gobgob/balise/solidworks/cahpeau.SLDPRT

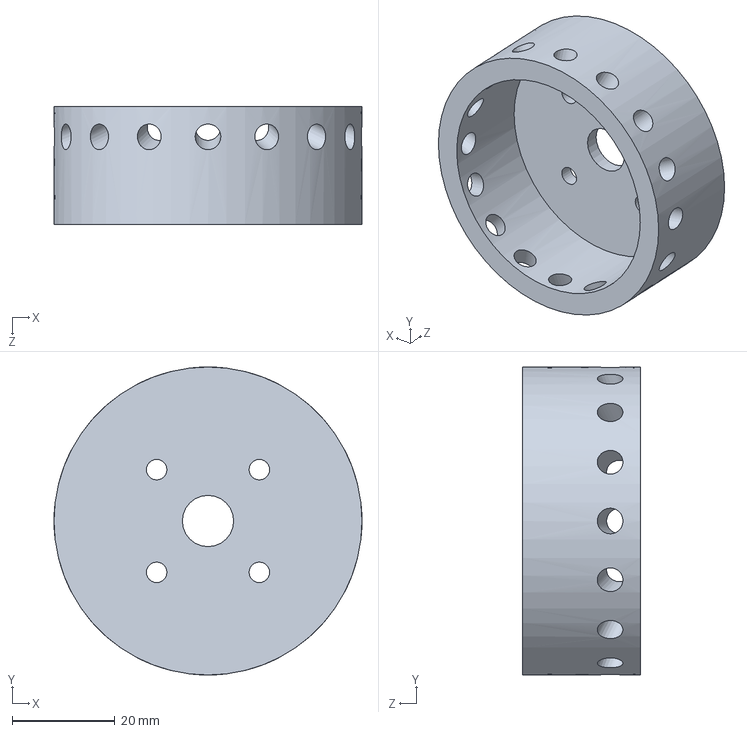
[picture p1: CAD file, 2015-05-18]
solidworks/cahpeau.SLDPRT
60.0 x 60.0 x 23.0 mm
