gobgob/balise/solidworks/haut.SLDPRT

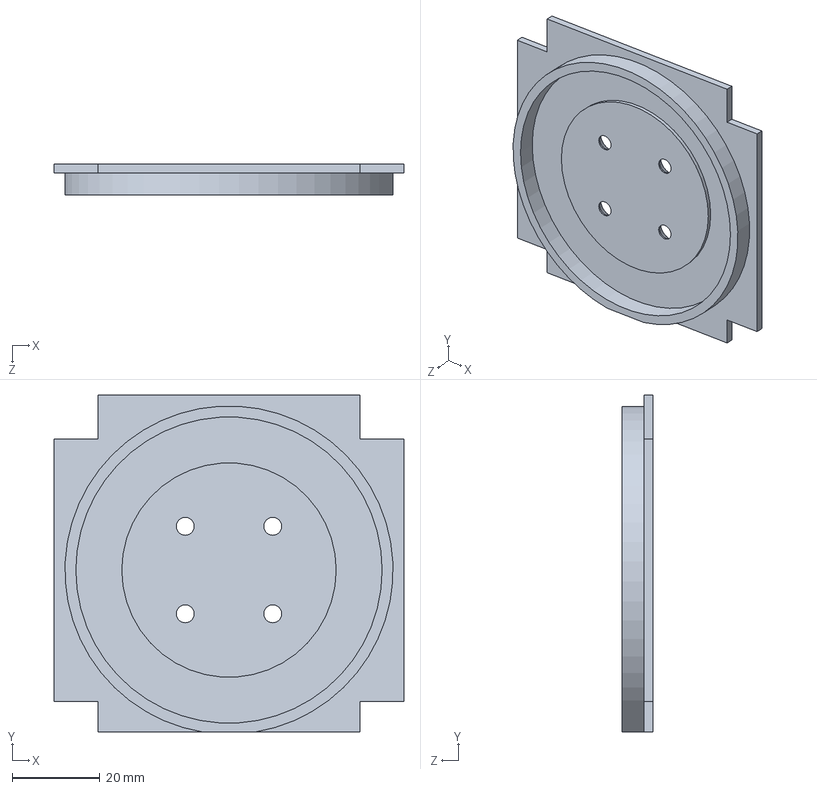
[picture p2: CAD file, 2015-05-18]
solidworks/haut.SLDPRT
80.0 x 77.0 x 7.00 mm
