gobgob/balise/solidworks/inter.SLDPRT

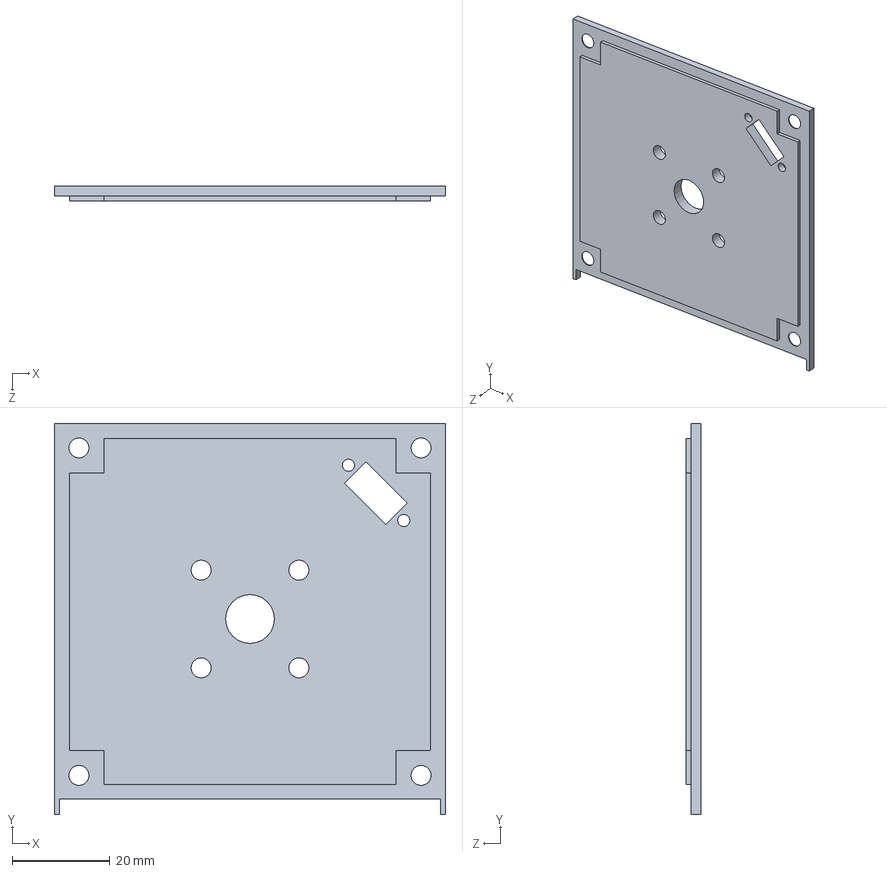
[picture p3: CAD file, 2015-05-18]
solidworks/inter.SLDPRT
80.0 x 80.0 x 3.00 mm
