gobgob/balise/solidworks/support_final.SLDPRT

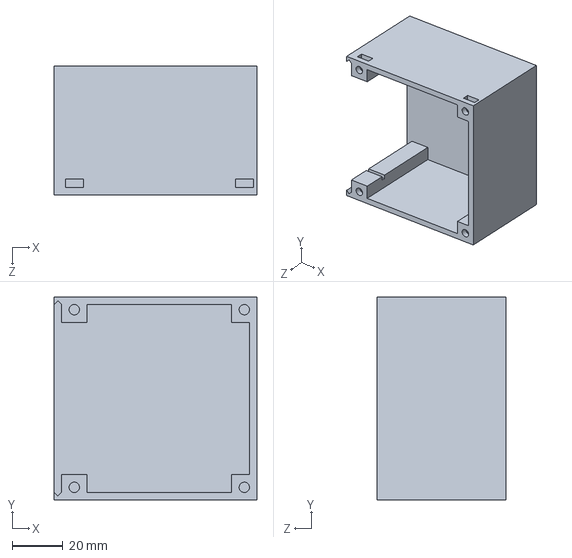
[picture p4: CAD file, 2015-05-18]
solidworks/support_final.SLDPRT
80.0 x 80.0 x 51.0 mm
