gobgob/balise/solidworks/capot.SLDPRT

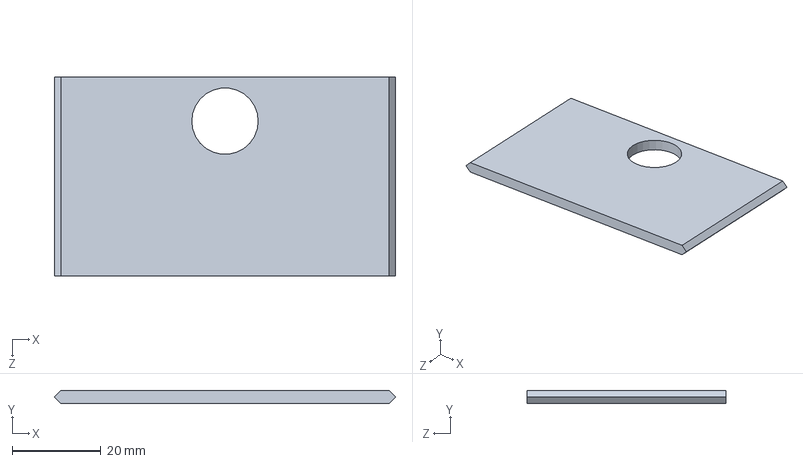
[picture p5: CAD file, 2015-05-18]
solidworks/capot.SLDPRT
77.0 x 3.00 x 45.0 mm
