gobgob/balise/(list of files, cad)

Other CAD files:
solidworks/cahpeau.STL
solidworks/capot.STL
solidworks/haut.STL
solidworks/inter.STL
solidworks/support_final.STL
