gobgob/balise/resultat/resultat_exploite.xlsx

K | Freq | Without LED | With led 60cm | With led 10cm
0 | 0 | 0 | 0 | 0
1 | 488.28125 | 90 | 4 | 196
2 | 976.5625 | 309 | 16 | 236
3 | 1464.84375 | 61 | 540 | 14934
4 | 1953.125 | 105 | 15 | 131
5 | 2441.40625 | 69 | 17 | 18
6 | 2929.6875 | 45 | 30 | 317
7 | 3417.96875 | 68 | 10 | 54
8 | 3906.25 | 40 | 12 | 37
9 | 4394.53125 | 82 | 65 | 4033
10 | 4882.8125 | 128 | 31 | 353
11 | 5371.09375 | 74 | 18 | 73
12 | 5859.375 | 106 | 16 | 177
13 | 6347.65625 | 163 | 11 | 38
14 | 6835.9375 | 120 | 15 | 148
15 | 7324.21875 | 22 | 56 | 1878
16 | 7812.5 | 143 | 10 | 54
17 | 8300.78125 | 84 | 1 | 36
18 | 8789.0625 | 238 | 8 | 141
19 | 9277.34375 | 133 | 64 | 99
20 | 9765.625 | 334 | 19 | 23
21 | 10253.90625 | 84 | 24 | 1118
22 | 10742.1875 | 22 | 17 | 189
23 | 11230.46875 | 29 | 10 | 16
24 | 11718.75 | 44 | 22 | 111
25 | 12207.03125 | 168 | 11 | 29
26 | 12695.3125 | 20 | 10 | 67
27 | 13183.59375 | 65 | 30 | 682
28 | 13671.875 | 310 | 13 | 118
29 | 14160.15625 | 558 | 9 | 269
30 | 14648.4375 | 404 | 18 | 41
31 | 15136.71875 | 104 | 7 | 73
32 | 15625 | 474 | 6 | 61
33 | 16113.28125 | 406 | 16 | 338
34 | 16601.5625 | 52 | 5 | 55
35 | 17089.84375 | 363 | 14 | 105
36 | 17578.125 | 65 | 9 | 138
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
