gobgob/balise/hardware/rx_mod-2.brd

## EAGLE design hardware/rx_mod-2.brd (2015-05-18)

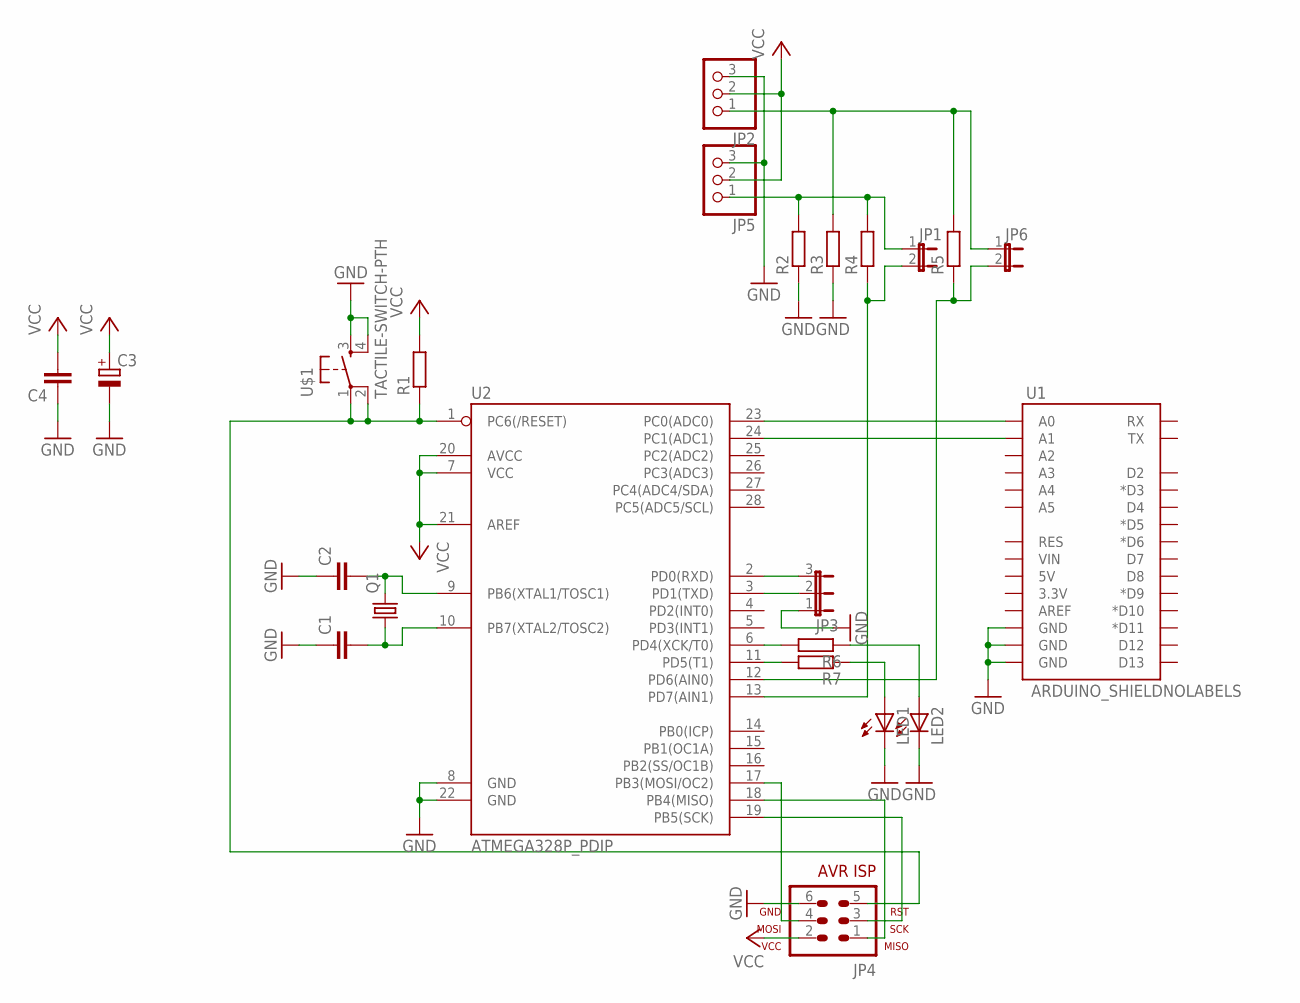
[picture p6: schematic rx_mod-2.sch]

Parts:
C1, C2, C4: C-EU050-030X075; C050-030X075
C3: CPOL-EUE2.5-6; E2,5-6
JP1, JP6: JP1E; JP1
JP2, JP5: PINHD-1X3/90; 1X03/90
JP3: JP2E; JP2
JP4: AVR-ISP-6VERT; AVR-ISP-6
LED1, LED2: LED5MM
Q1: CRYSTALHC49U70; HC49U70
R1, R2, R3, R4, R5, R6, R7: R-EU_0207/10; 0207/10
U1: ARDUINO_SHIELDNOLABELS; DUEMILANOVE_SHIELD_NOLABELS
U2: ATMEGA328P_PDIP; DIL28-3
U$1: TACTILE-SWITCH-PTH; TAC-SWITCH-PTH

Connections:
GND: C1.1, C2.1, C3.-, C4.1, JP2.3, JP3.1, JP4.6, JP5.3, LED1.K (C), LED2.K (C), R2.1, R3.1, U1.GND@0 (GND), U1.GND@1 (GND), U1.GND@2 (GND), U2.8 (GND), U2.22 (GND), U$1.3, U$1.4
unnamed: JP6.2, R5.1, U2.12 (PD6(AIN0))
unnamed: JP1.2, R4.1, U2.13 (PD7(AIN1))
unnamed: JP1.1, JP5.1, R2.2, R4.2
unnamed: JP2.1, JP6.1, R3.2, R5.2
unnamed: JP4.5, R1.1, U2.1 (PC6(/RESET)), U$1.1, U$1.2
unnamed: JP3.2, U2.3 (PD1(TXD))
unnamed: JP3.3, U2.2 (PD0(RXD))
unnamed: C2.2, Q1.2, U2.9 (PB6(XTAL1/TOSC1))
unnamed: C1.2, Q1.1, U2.10 (PB7(XTAL2/TOSC2))
unnamed: JP4.4, U2.17 (PB3(MOSI/OC2))
unnamed: JP4.1, U2.18 (PB4(MISO))
unnamed: JP4.3, U2.19 (PB5(SCK))
unnamed: R7.2, U2.11 (PD5(T1))
unnamed: R6.2, U2.6 (PD4(XCK/T0))
unnamed: LED2.A, R6.1
unnamed: LED1.A, R7.1
unnamed: U1.A0, U2.23 (PC0(ADC0))
unnamed: U1.A1, U2.24 (PC1(ADC1))
VCC: C3.+, C4.2, JP2.2, JP4.2, JP5.2, R1.2, U2.7 (VCC), U2.20 (AVCC), U2.21 (AREF)

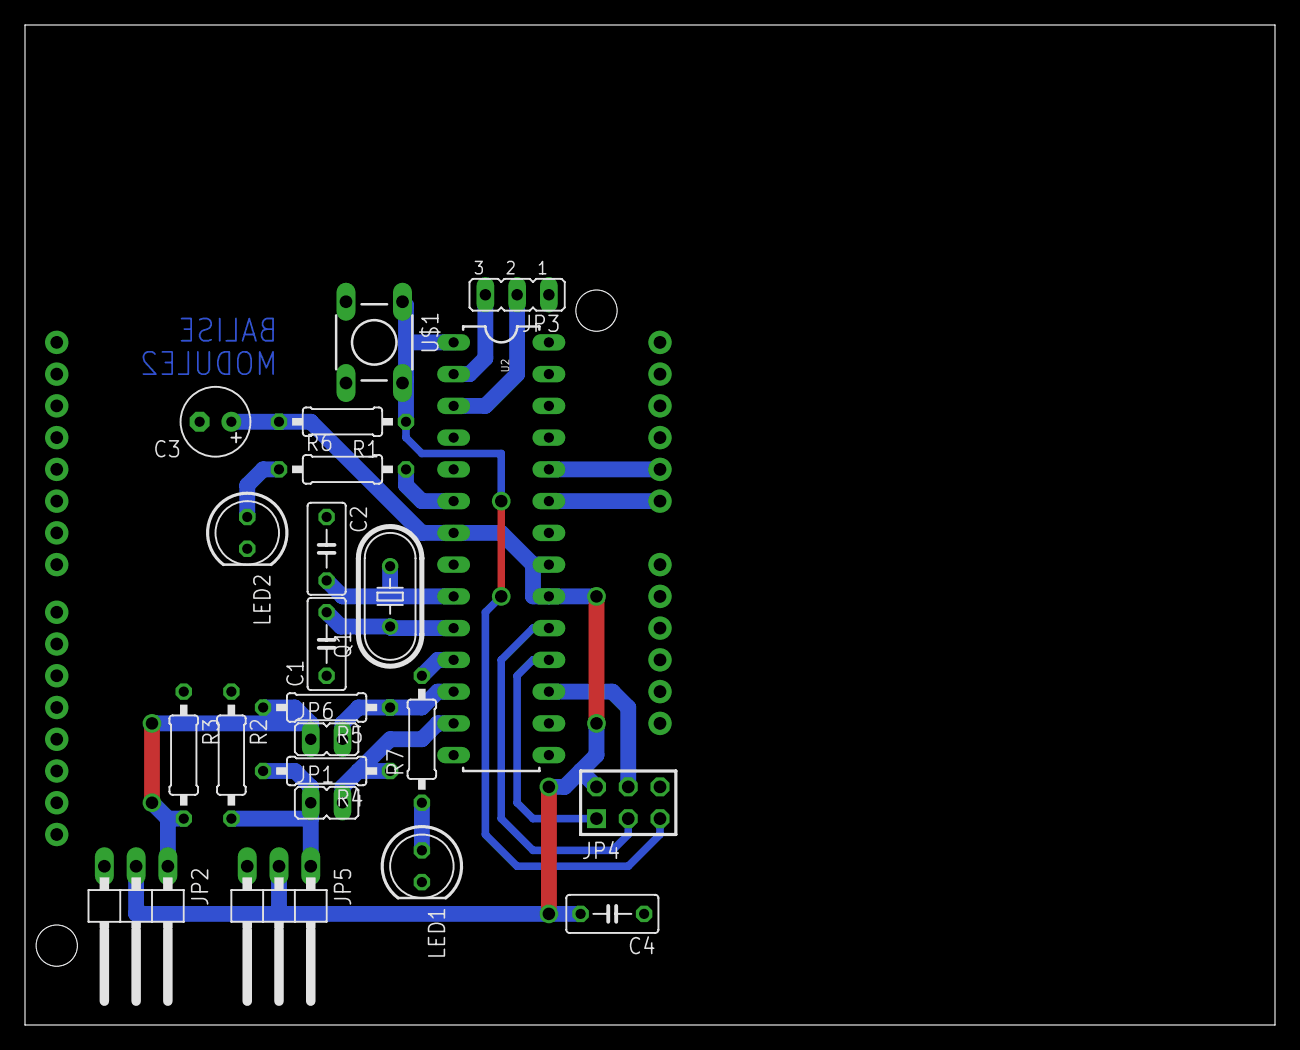
[picture p7: board rx_mod-2.brd from above]

Board: 2 copper layers, 100.0 x 80.0 mm, 23 parts (0 on the bottom side), 20 nets.
