gobgob/balise/hardware/tx.brd

## EAGLE design hardware/tx.brd (2015-05-18)

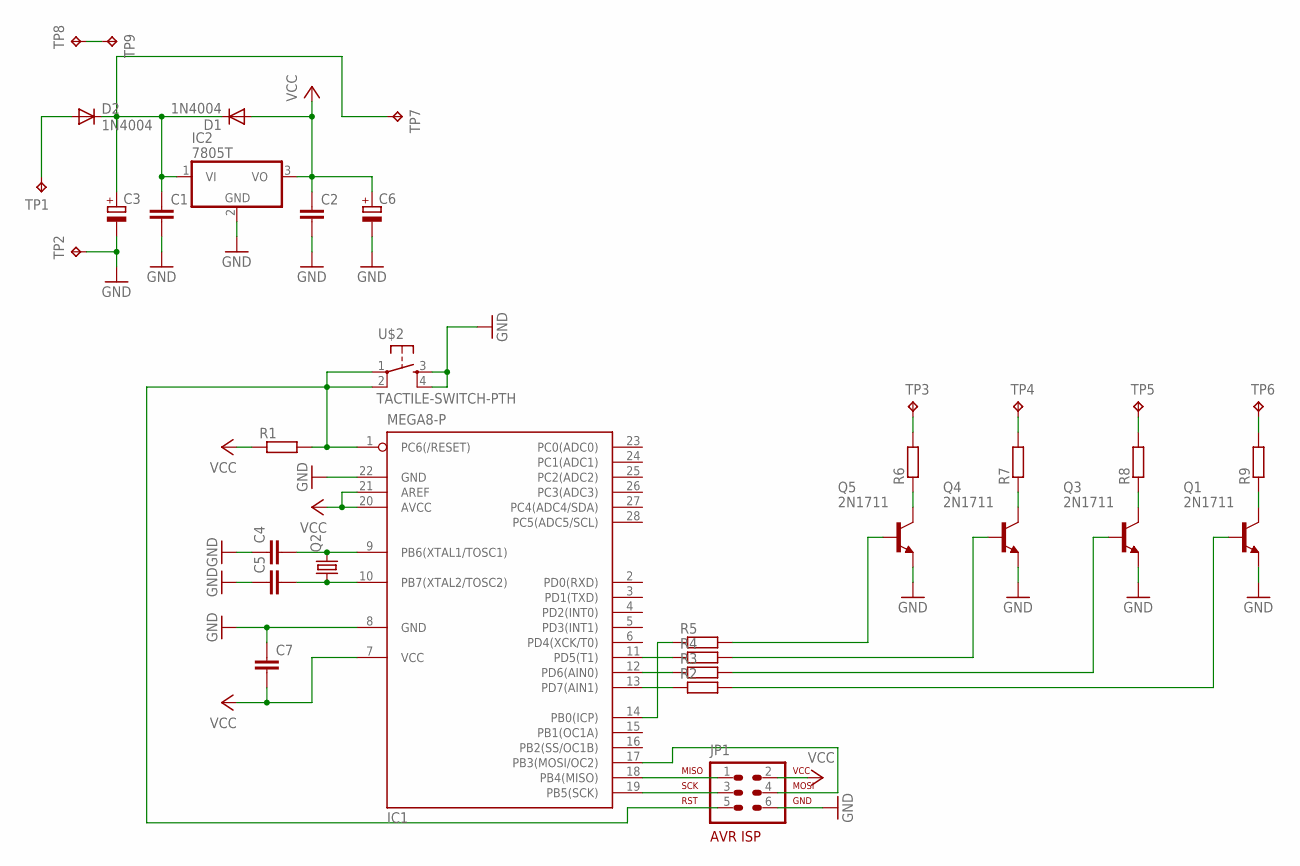
[picture p8: schematic tx.sch]

Parts:
C1, C2, C4, C5, C7: C-EU050-030X075; C050-030X075
C3, C6: CPOL-EUE3.5-8; E3,5-8
D1, D2: 1N4004; DO41-10
IC1: MEGA8-P; DIL28-3
IC2: 7805T; TO220H
JP1: AVR-ISP-6HORZ; AVR-ISP-6R
Q1, Q3, Q4, Q5: 2N1711; TO39
Q2: CRYSTALHC49U70; HC49U70
R1, R2, R3, R4, R5, R6, R7, R8, R9: R-EU_0204/7; 0204/7
TP1, TP2, TP3, TP4, TP5, TP6, TP7, TP8, TP9: TPPAD1-13Y; P1-13Y
U$2: TACTILE-SWITCH-PTH; TAC-SWITCH-PTH

Connections:
GND: C1.2, C2.2, C3.-, C4.1, C5.1, C6.-, C7.1, IC1.8 (GND), IC1.22 (GND), IC2.2 (GND), JP1.6, Q1.1 (E), Q3.1 (E), Q4.1 (E), Q5.1 (E), TP2.TP, U$2.3, U$2.4
unnamed: TP8.TP, TP9.TP
unnamed: C1.1, C3.+, D1.C, D2.C, IC2.1 (VI), TP7.TP
unnamed: IC1.1 (PC6(/RESET)), JP1.5, R1.2, U$2.1, U$2.2
unnamed: IC1.18 (PB4(MISO)), JP1.1
unnamed: IC1.19 (PB5(SCK)), JP1.3
unnamed: IC1.17 (PB3(MOSI/OC2)), JP1.4
unnamed: IC1.14 (PB0(ICP)), R5.1
unnamed: C4.2, IC1.9 (PB6(XTAL1/TOSC1)), Q2.2
unnamed: C5.2, IC1.10 (PB7(XTAL2/TOSC2)), Q2.1
unnamed: D2.A, TP1.TP
unnamed: IC1.11 (PD5(T1)), R4.1
unnamed: IC1.12 (PD6(AIN0)), R3.1
unnamed: IC1.13 (PD7(AIN1)), R2.1
unnamed: R6.2, TP3.TP
unnamed: R7.2, TP4.TP
unnamed: R8.2, TP5.TP
unnamed: R9.2, TP6.TP
unnamed: Q1.3 (C), R9.1
unnamed: Q3.3 (C), R8.1
unnamed: Q4.3 (C), R7.1
unnamed: Q5.3 (C), R6.1
unnamed: Q1.2 (B), R2.2
unnamed: Q3.2 (B), R3.2
unnamed: Q4.2 (B), R4.2
unnamed: Q5.2 (B), R5.2
VCC: C2.1, C6.+, C7.2, D1.A, IC1.7 (VCC), IC1.20 (AVCC), IC1.21 (AREF), IC2.3 (VO), JP1.2, R1.1

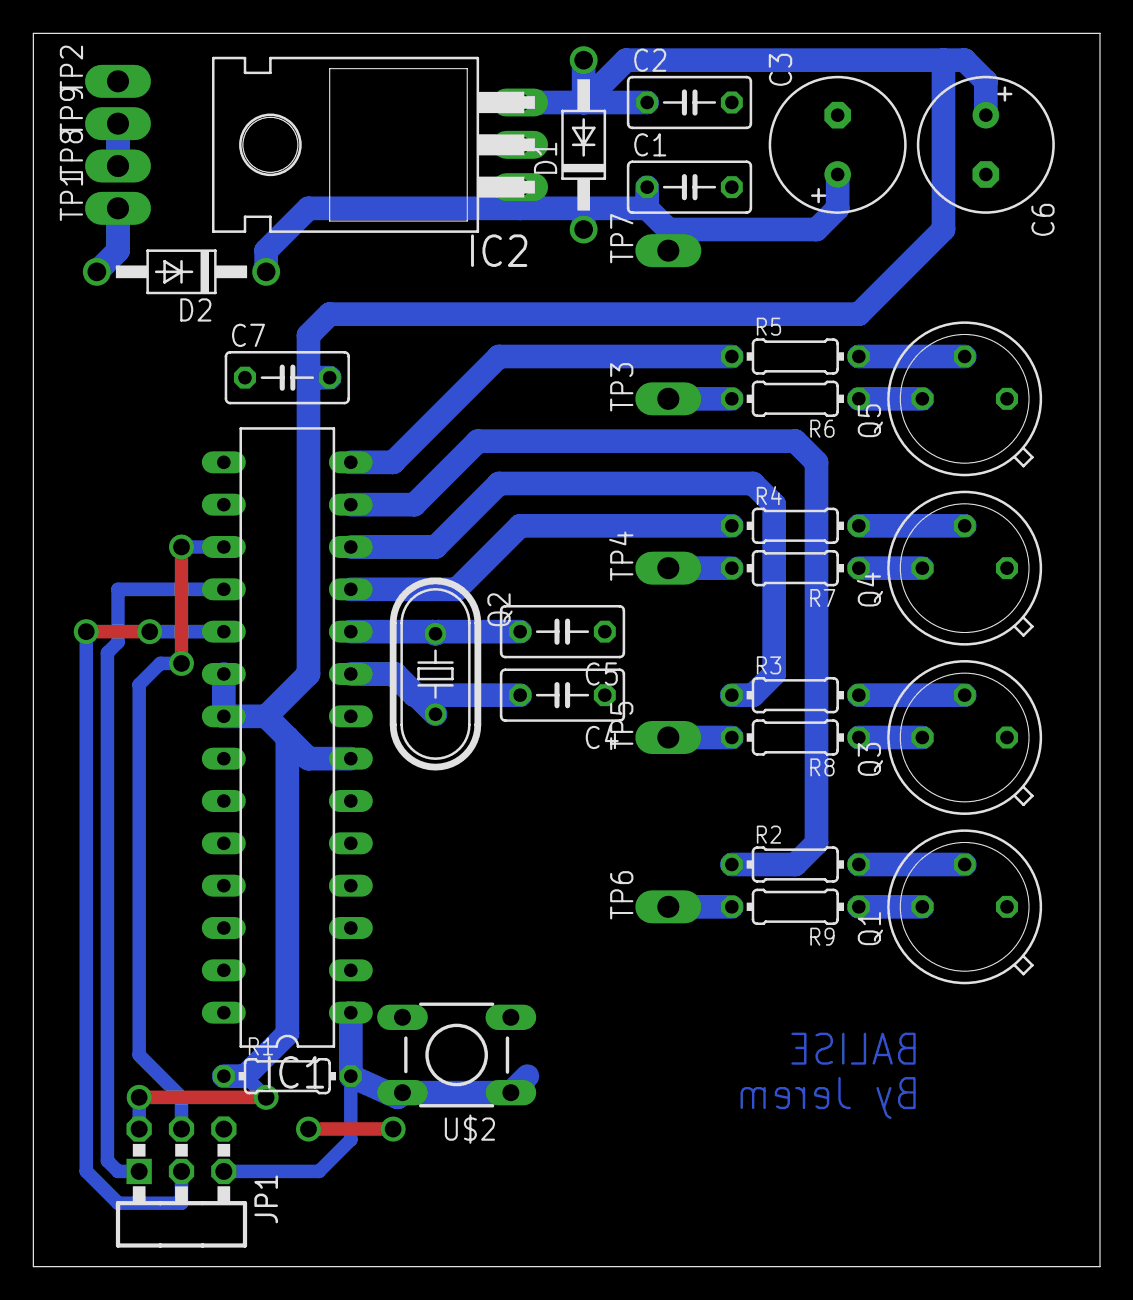
[picture p9: board tx.brd from above]

Board: 2 copper layers, 64.0 x 74.0 mm, 36 parts (0 on the bottom side), 27 nets.
