gobgob/balise/hardware/rx_mod-1.brd

## EAGLE design hardware/rx_mod-1.brd (2015-05-18)

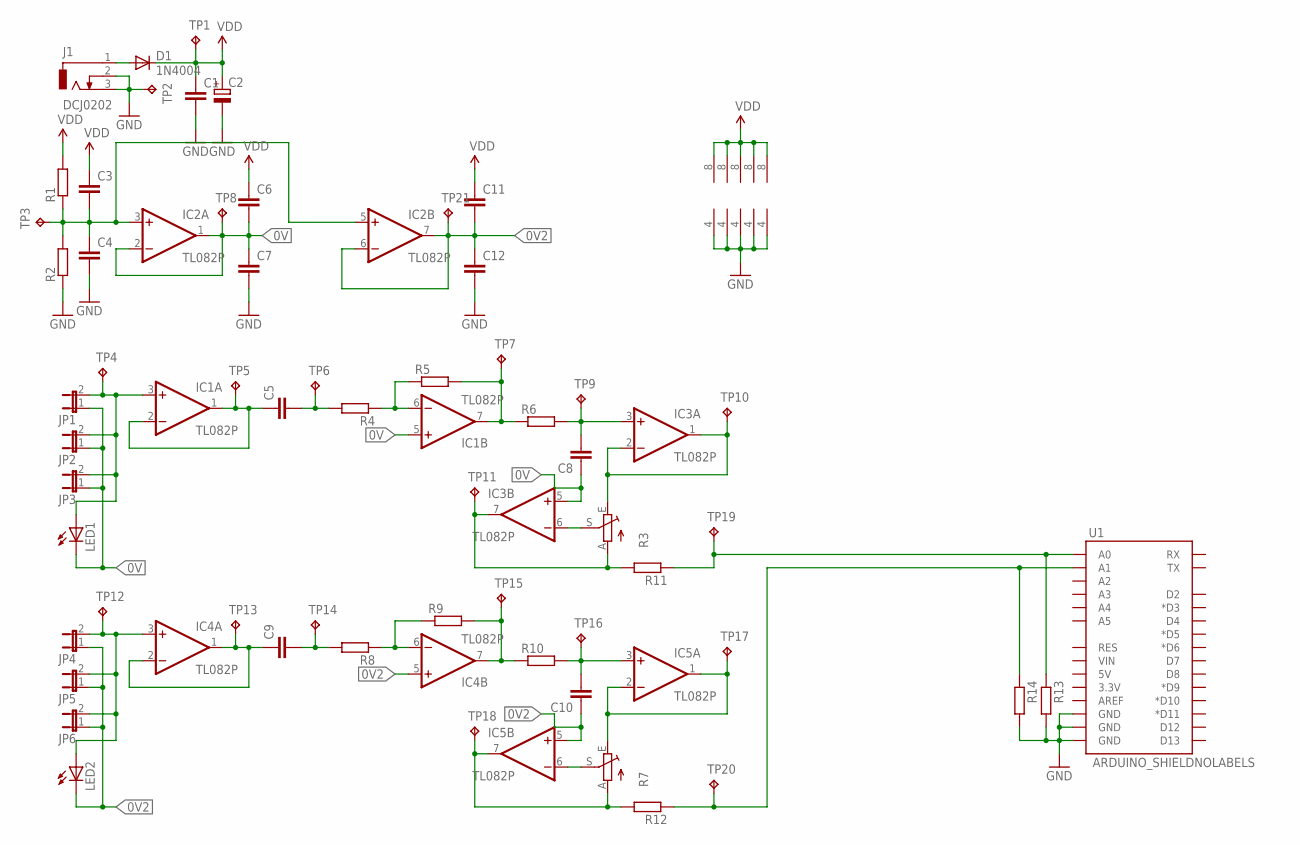
[picture p10: schematic rx_mod-1.sch]

Parts:
C1, C3, C4, C5, C6, C7, C8, C9, C10, C11, C12: C-EU050-030X075; C050-030X075
C2: CPOL-EUE2.5-6; E2,5-6
D1: 1N4004; DO41-10
IC1, IC2, IC3, IC4, IC5: TL082P; DIL08
J1: DCJ0202
JP1, JP2, JP3, JP4, JP5, JP6: JP1E; JP1
LED1, LED2: LED5MM
R1, R2, R4, R8, R11, R12, R13, R14: R-EU_0207/10; 0207/10
R3, R7: TRIM_EU-CA9V; CA9V
R5, R6, R9, R10: R-EU_0207/2V; 0207/2V
TP1, TP2, TP3, TP4, TP5, TP6, TP7, TP8, TP9, TP10, TP11, TP12, TP13, TP14, TP15, TP16, TP17, TP18, TP19, TP20, TP21: TPPAD1-13; P1-13
U1: ARDUINO_SHIELDNOLABELS; DUEMILANOVE_SHIELD_NOLABELS

Connections:
0V: C6.2, C7.1, C8.1, IC1.5 (+IN), IC2.1 (OUT), IC2.2 (-IN), IC3.5 (+IN), JP1.1, JP2.1, JP3.1, LED1.K (C), TP8.TP
0V2: C10.1, C11.2, C12.1, IC2.6 (-IN), IC2.7 (OUT), IC4.5 (+IN), IC5.5 (+IN), JP4.1, JP5.1, JP6.1, LED2.K (C), TP21.TP
GND: C1.2, C2.-, C4.2, C7.2, C12.2, IC1.4 (V-), IC2.4 (V-), IC3.4 (V-), IC4.4 (V-), IC5.4 (V-), J1.2, J1.3, R2.1, R13.2, R14.2, TP2.TP, U1.GND@0 (GND), U1.GND@1 (GND), U1.GND@2 (GND)
unnamed: D1.A, J1.1
unnamed: C5.1, IC1.1 (OUT), IC1.2 (-IN), TP5.TP
unnamed: IC1.3 (+IN), JP1.2, JP2.2, JP3.2, LED1.A, TP4.TP
unnamed: C5.2, R4.2, TP6.TP
unnamed: IC1.6 (-IN), R4.1, R5.1
unnamed: IC1.7 (OUT), R5.2, R6.1, TP7.TP
unnamed: C8.2, IC3.3 (+IN), R6.2, TP9.TP
unnamed: C3.2, C4.1, IC2.3 (+IN), IC2.5 (+IN), R1.1, R2.2, TP3.TP
unnamed: IC3.1 (OUT), IC3.2 (-IN), R3.E, TP10.TP
unnamed: IC4.3 (+IN), JP4.2, JP5.2, JP6.2, LED2.A, TP12.TP
unnamed: IC3.6 (-IN), R3.S
unnamed: IC3.7 (OUT), R3.A, R11.2, TP11.TP
unnamed: C9.1, IC4.1 (OUT), IC4.2 (-IN), TP13.TP
unnamed: C9.2, R8.2, TP14.TP
unnamed: IC4.6 (-IN), R8.1, R9.1
unnamed: IC4.7 (OUT), R9.2, R10.1, TP15.TP
unnamed: C10.2, IC5.3 (+IN), R10.2, TP16.TP
unnamed: IC5.1 (OUT), IC5.2 (-IN), R7.E, TP17.TP
unnamed: IC5.6 (-IN), R7.S
unnamed: IC5.7 (OUT), R7.A, R12.2, TP18.TP
unnamed: R11.1, R13.1, TP19.TP, U1.A0
unnamed: R12.1, R14.1, TP20.TP, U1.A1
VDD: C1.1, C2.+, C3.1, C6.1, C11.1, D1.C, IC1.8 (V+), IC2.8 (V+), IC3.8 (V+), IC4.8 (V+), IC5.8 (V+), R1.2, TP1.TP

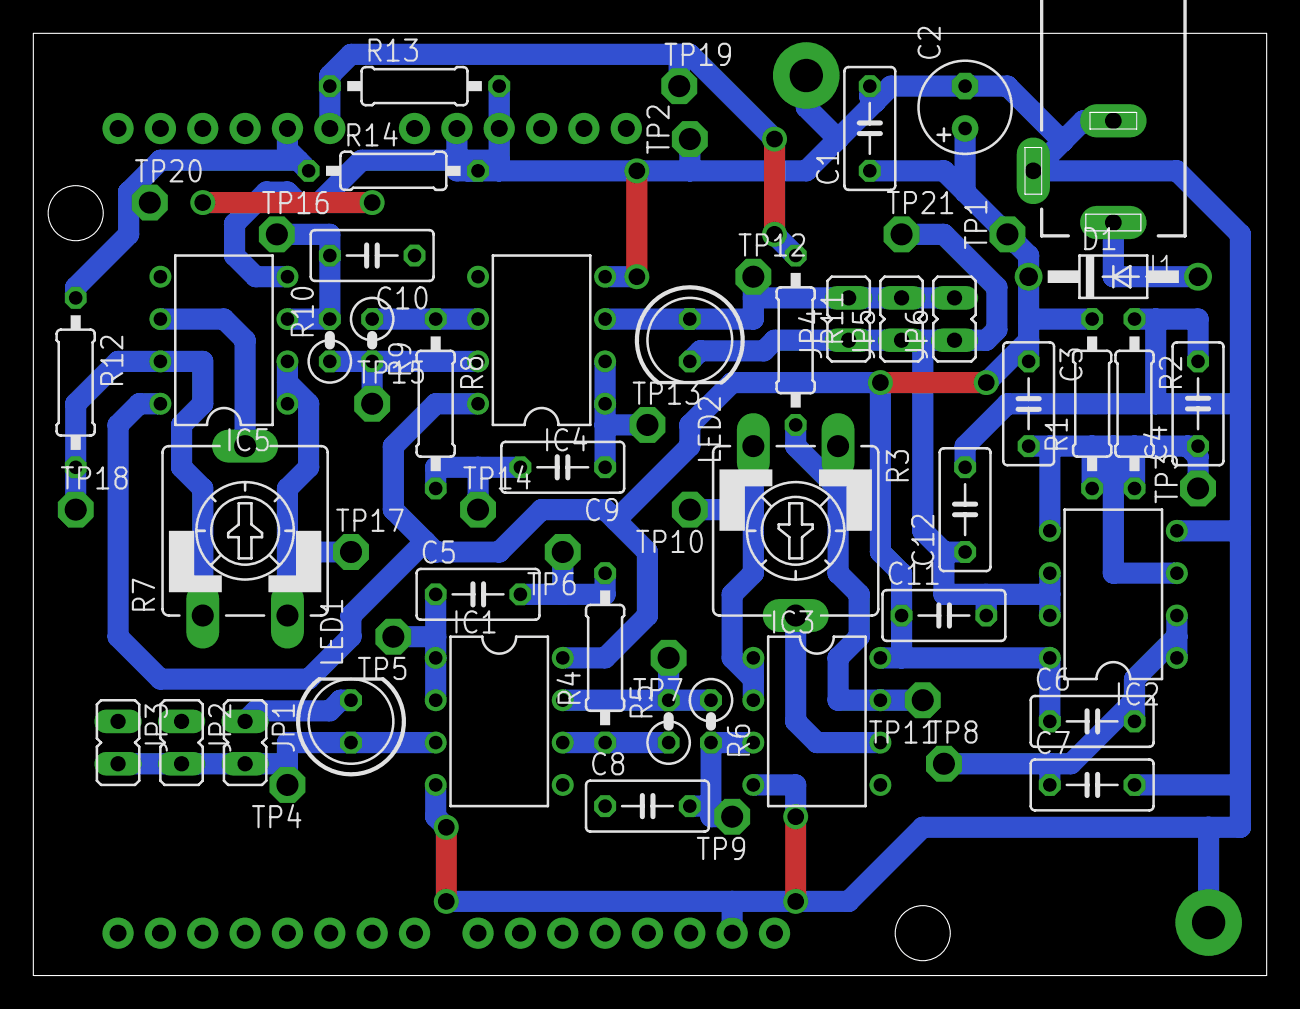
[picture p11: board rx_mod-1.brd from above]

Board: 2 copper layers, 74.0 x 56.5 mm, 63 parts (0 on the bottom side), 26 nets.
