gobgob/balise/hardware/rx.brd

## EAGLE design hardware/rx.brd (2015-05-18)

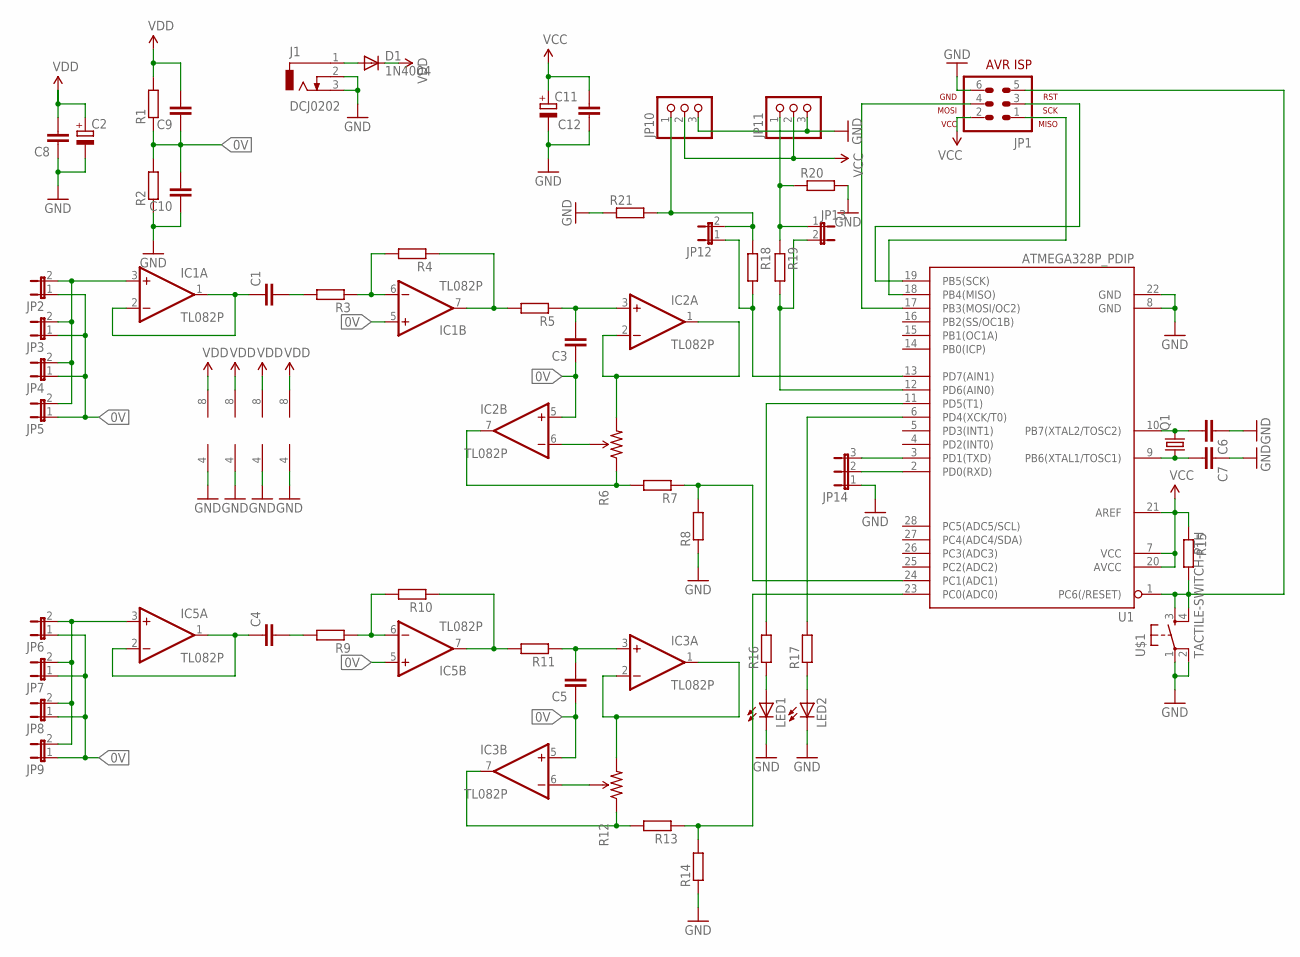
[picture p12: schematic rx.sch]

Parts:
C1, C3, C4, C5, C6, C7, C8, C9, C10, C12: C-EU050-030X075; C050-030X075
C2, C11: CPOL-EUE5-8.5; E5-8,5
D1: 1N4004; DO41-10
IC1, IC2, IC3, IC5: TL082P; DIL08
J1: DCJ0202
JP1: AVR-ISP-6VERT; AVR-ISP-6
JP2, JP3, JP4, JP5, JP6, JP7, JP8, JP9, JP12, JP13: JP1E; JP1
JP10, JP11: PINHD-1X3/90; 1X03/90
JP14: JP2E; JP2
LED1, LED2: LED5MM
Q1: CRYSTALHC49U70; HC49U70
R1, R2, R3, R7, R8, R9, R13, R14, R15, R16, R17, R18, R19, R20, R21: R-EU_0207/10; 0207/10
R4, R5, R10, R11: R-EU_0207/2V; 0207/2V
R6, R12: TRIMPOTPTH; TRIM_POT_PTH
U1: ATMEGA328P_PDIP; DIL28-3
U$1: TACTILE-SWITCH-PTH; TAC-SWITCH-PTH

Connections:
0V: C3.1, C5.1, C9.1, C10.2, IC1.5 (+IN), IC2.5 (+IN), IC3.5 (+IN), IC5.5 (+IN), JP2.1, JP3.1, JP4.1, JP5.1, JP6.1, JP7.1, JP8.1, JP9.1, R1.1, R2.2
GND: C2.-, C6.1, C7.1, C8.1, C10.1, C11.-, C12.1, IC1.4 (V-), IC2.4 (V-), IC3.4 (V-), IC5.4 (V-), J1.2, J1.3, JP1.6, JP10.3, JP11.3, JP14.1, LED1.K (C), LED2.K (C), R2.1, R8.1, R14.1, R20.2, R21.1, U1.8 (GND), U1.22 (GND), U$1.1, U$1.2
unnamed: C1.1, IC1.1 (OUT), IC1.2 (-IN)
unnamed: IC1.3 (+IN), JP2.2, JP3.2, JP4.2, JP5.2
unnamed: C1.2, R3.2
unnamed: IC1.6 (-IN), R3.1, R4.2
unnamed: IC1.7 (OUT), R4.1, R5.2
unnamed: IC2.1 (OUT), IC2.2 (-IN), R6.3 (CW)
unnamed: C3.2, IC2.3 (+IN), R5.1
unnamed: D1.A, J1.1
unnamed: IC2.6 (-IN), R6.2 (WIPER)
unnamed: IC2.7 (OUT), R6.1 (CCW), R7.2
unnamed: R7.1, R8.2, U1.24 (PC1(ADC1))
unnamed: IC5.3 (+IN), JP6.2, JP7.2, JP8.2, JP9.2
unnamed: C4.1, IC5.1 (OUT), IC5.2 (-IN)
unnamed: C4.2, R9.2
unnamed: IC5.6 (-IN), R9.1, R10.2
unnamed: IC5.7 (OUT), R10.1, R11.2
unnamed: IC3.1 (OUT), IC3.2 (-IN), R12.3 (CW)
unnamed: C5.2, IC3.3 (+IN), R11.1
unnamed: IC3.6 (-IN), R12.2 (WIPER)
unnamed: IC3.7 (OUT), R12.1 (CCW), R13.2
unnamed: R13.1, R14.2, U1.23 (PC0(ADC0))
unnamed: JP11.1, JP13.1, R19.1, R20.1
unnamed: C7.2, Q1.1, U1.9 (PB6(XTAL1/TOSC1))
unnamed: C6.2, Q1.2, U1.10 (PB7(XTAL2/TOSC2))
unnamed: JP10.1, JP12.2, R18.1, R21.2
unnamed: JP14.3, U1.3 (PD1(TXD))
unnamed: JP14.2, U1.2 (PD0(RXD))
unnamed: JP1.5, R15.2, U1.1 (PC6(/RESET)), U$1.3, U$1.4
unnamed: JP1.1, U1.18 (PB4(MISO))
unnamed: JP1.3, U1.19 (PB5(SCK))
unnamed: JP1.4, U1.17 (PB3(MOSI/OC2))
unnamed: LED1.A, R16.1
unnamed: LED2.A, R17.1
unnamed: R17.2, U1.6 (PD4(XCK/T0))
unnamed: R16.2, U1.11 (PD5(T1))
unnamed: JP13.2, R19.2, U1.12 (PD6(AIN0))
unnamed: JP12.1, R18.2, U1.13 (PD7(AIN1))
VCC: C11.+, C12.2, JP1.2, JP10.2, JP11.2, R15.1, U1.7 (VCC), U1.20 (AVCC), U1.21 (AREF)
VDD: C2.+, C8.2, C9.2, D1.C, IC1.8 (V+), IC2.8 (V+), IC3.8 (V+), IC5.8 (V+), R1.2

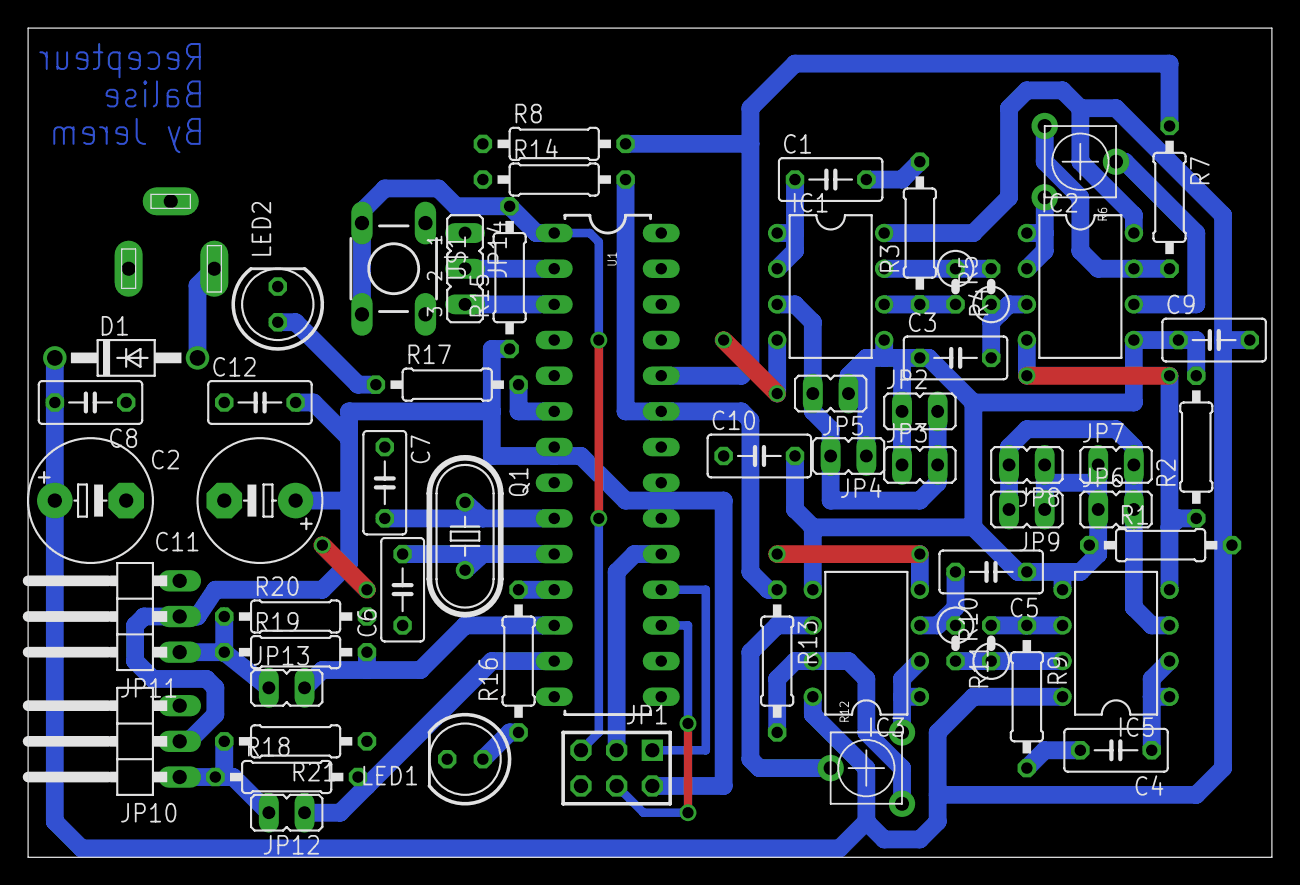
[picture p13: board rx.brd from above]

Board: 2 copper layers, 88.6 x 59.0 mm, 58 parts (1 on the bottom side), 41 nets.
