gobgob/balise/receiver/src/sin_table.c

#include "sin_table.h"
#include "fft.h"
#include <inttypes.h>

const double fft_cos_table[SAMPLE_SIZE] = {
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
};

double cos_table(uint8_t k)
{
	return fft_cos_table[k];
}

double sin_table(uint8_t k)
{
	return fft_sin_table[k];
}
