gobgob/balise/(commit log)

2014-05-25 Add timer 0
2014-05-25 Add adc
2014-05-25 Change TIMER 0 OVF (with prescaler)
2014-05-26 Add uart for debug : implementation isn't finish
2014-05-26 update ADC convert
2014-05-26 add ISR for useless interrupt (just in case)
2014-05-26 Add uart in Makefile
2014-05-26 FFT compute with avr
    [with_led_10cm.csv, with_led_40cm.csv, without_led.csv]
2014-05-26 add exploit result on excel
    [resultat_exploite.xlsx]
2014-05-26 update exploited result
    [resultat_exploite.xlsx]
2015-05-18 Add ability to choose ADC
2015-05-18 Add other LED debug (like on schematic)
2015-05-18 Update main to check on the 2 side of robot
    And send value on uart
2015-05-18 Add Hardware schematic and board for balise
    [rx.brd, rx.sch, rx_mod-1.brd, rx_mod-1.sch, rx_mod-2.brd, rx_mod-2.sch, tx.brd, tx.sch]
2015-05-18 Add solidworks file to print balise
    [cahpeau.SLDPRT, cahpeau.STL, capot.SLDPRT, capot.STL, haut.SLDPRT, haut.STL, inter.SLDPRT, inter.STL]
